eminnnnnnn/sensors_control_system/docs/kicad project/course.odt

Поз. обозначе- ние | Наименование | Кол. | Примечание
| Источники питания
BT1 | 3 В | 1
| Конденсаторы
C1 | 0,1 мкФ | 1
C2 | 10мк*10 | 1
C3-C9 | 0,1 мкФ | 7
C10, C11 | 15 пФ | 2
C12-C18 | 0,1 мкФ | 7
C19, C20 | 33 пФ | 2
| Схемы интегральные
D1 | BAT54C | 1
D2 | LED | 1
D3 | K1986BE92QI | 1
| Индикаторы символьные
HG1 | MT-12864j | 1
| Резисторы
R1-R5 | 10 кОм | 5
R6 | 1 кОм | 1
R7 | 10 кОм | 1
R8 | 3,3 кОм | 1
R9 | 47 кОм | 1
R10 | 10 кОм | 1
R11, R12 | 47 кОм | 2
R13, R14 | 10 кОм | 2
R15 | 47 кОм | 1

Подп. дата
Инв. № дубл.
Взам. инв. №
Подп. и дата
Инв. № подл.

| | | | | Система контроля показаний цифровых датчиков
Изм. | Лист | № докум. | Подп | Дата
Разраб. | | Гаджиев Э.А. | | | Перечень элементов | Лит. | | | Лист | Листов
Пров. | | Хохлов С.А. | | | | | | | 1 | 2
| | | | | | МГТУ им. Н.Э. Баумана
Н. контр.
Утв.

Поз. обозначе- ние | Наименование | Кол. | Примечание
| Выключатели кнопочные
SB1-SB6 | SB_PUSH_NO | 6
| Преобразователи
U1 | LM1117-3.3 | 1
| Схемы интегральные
U2 | DHT11 | 1
| Кварцевые резонаторы
Y1 | 8 МГц | 1
Y2 | Crystal | 1
| Фильтры
Z1 | BNX002 | 1

| | | | | Система контроля показаний цифровых датчиков | Лист
| | | | | | 2
Изм. | Лист | № докум. | Подп. | Дата

Подп. дата
Инв. № дубл.
Взам. инв. №
Подп. и дата
Инв. № подл.

Копировал Формат А4
