eminnnnnnn/sensors_control_system/docs/functional.JPG

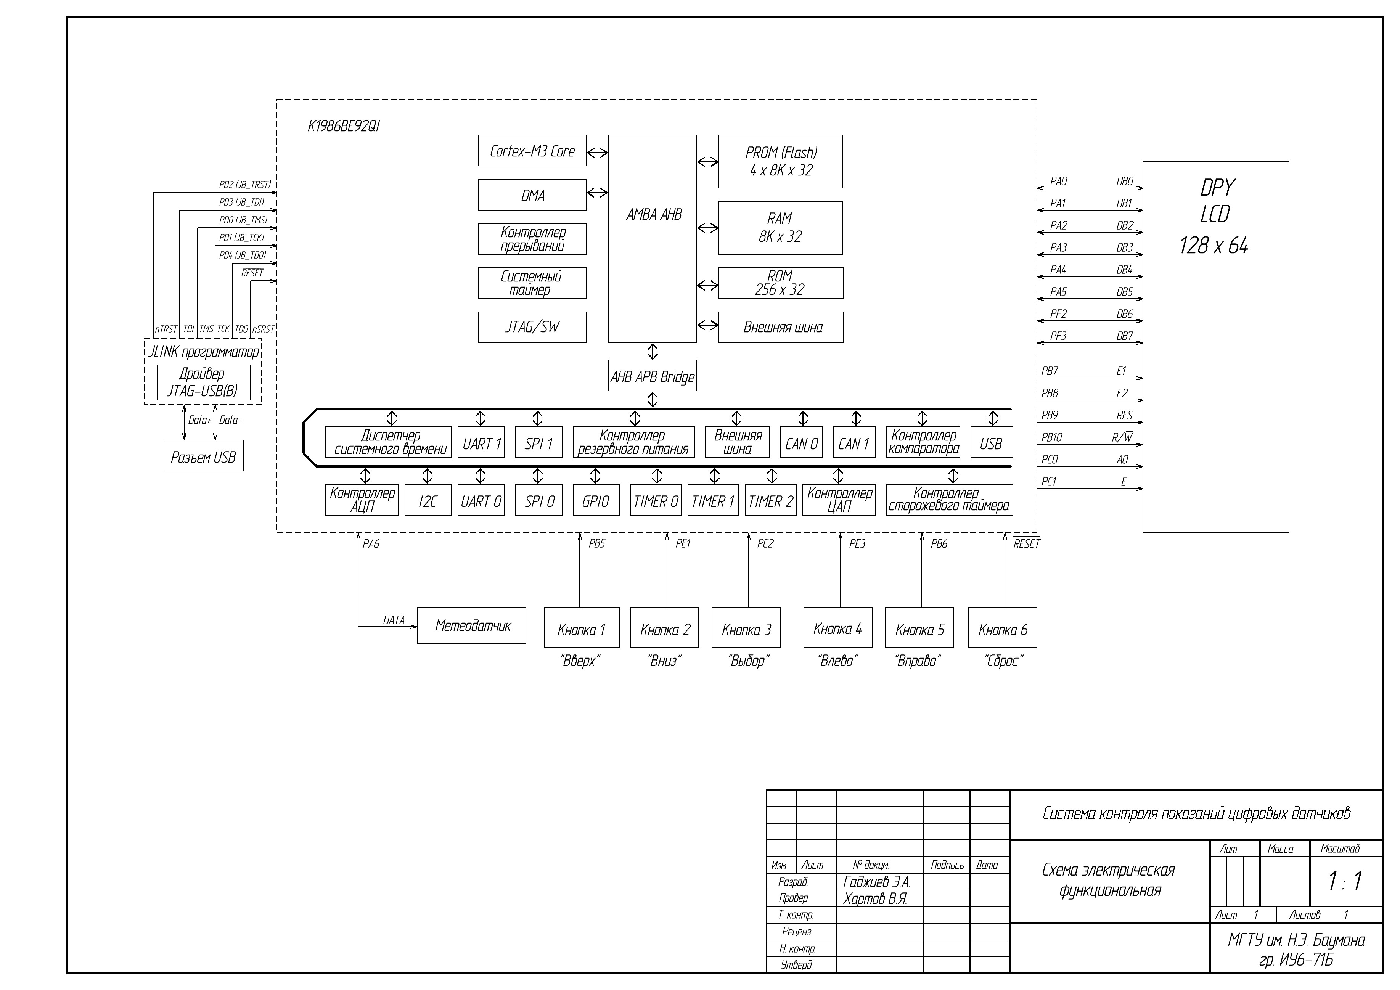
docs/functional.JPG
