eminnnnnnn/sensors_control_system/docs/principal.JPG

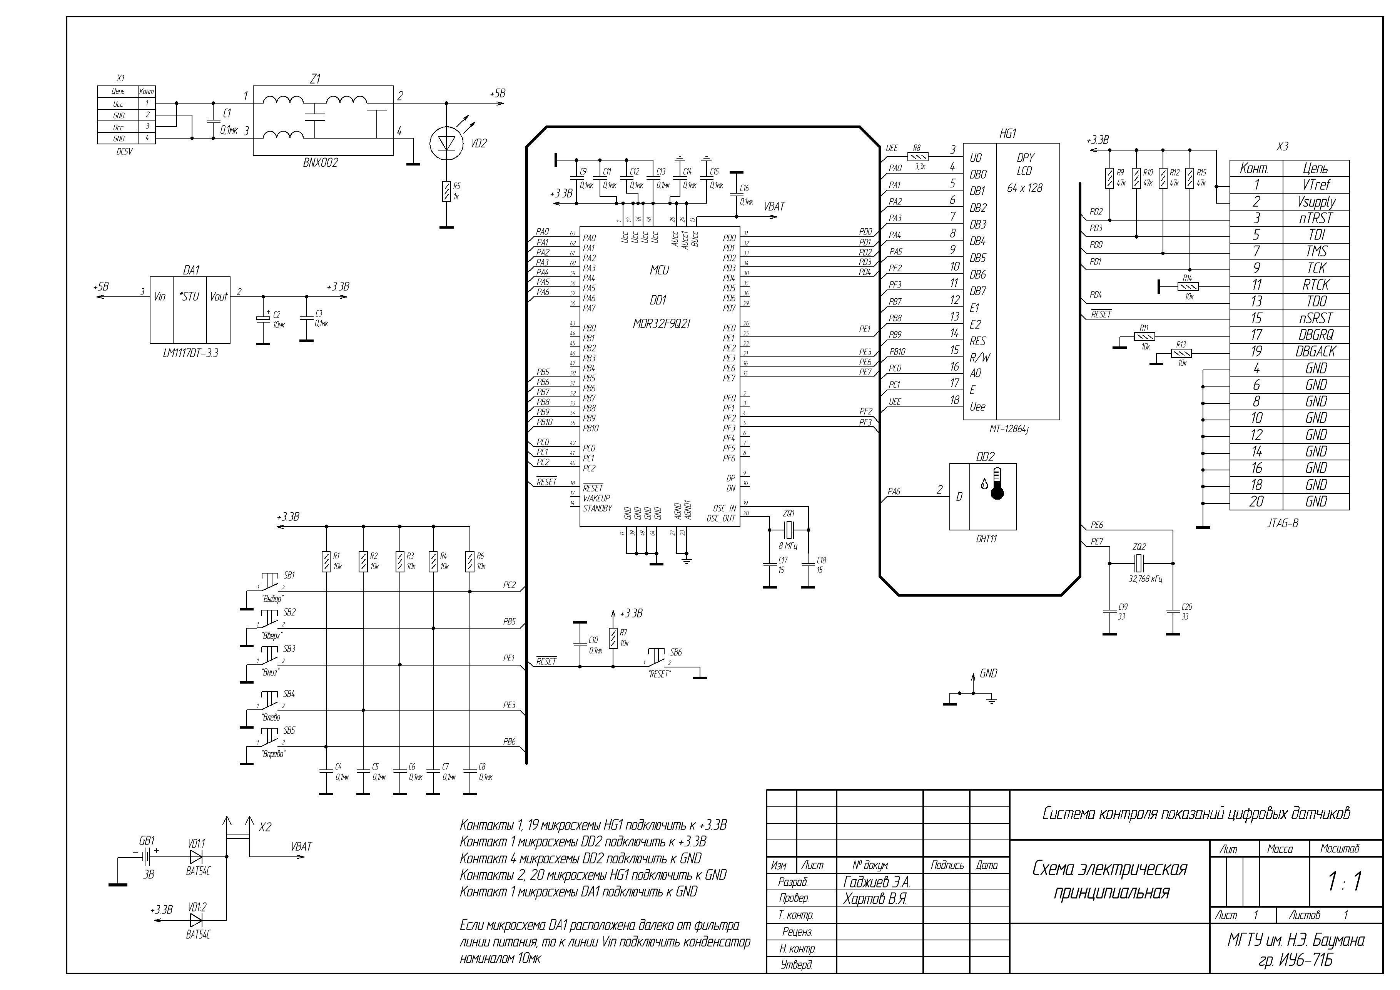
docs/principal.JPG
