eminnnnnnn/sensors_control_system/(list of files, drawings)

Other design files:
docs/functional.spl7
docs/principal.spl7
