eminnnnnnn/sensors_control_system/src/lcd_menu.c

#include "lcd_menu.h"
#include "auth.h"
#include "sensors.h"
#include "rtc.h"

//////////////////////////////////////////////////////////////////////////////////////////
/* ------------------------ PRIVATE FUNCTION DEFINITIONS ------------------------------ */
//////////////////////////////////////////////////////////////////////////////////////////

uint8_t * get_symbol_array_for_LCD(const char symbol)
{
	switch(symbol)
	{
		case 'a': return lat_a;
		case 'b': return lat_b;
		case 'c': return lat_c;
		case 'd': return lat_d;
		case 'e': return lat_e;
		case 'f': return lat_f;
		case 'g': return lat_g;
		case 'h': return lat_h;
		case 'i': return lat_i;
		case 'j': return lat_j;
		case 'k': return lat_k;
		case 'l': return lat_l;
		case 'm': return lat_m;
		case 'n': return lat_n;
		case 'o': return lat_o;
		case 'p': return lat_p;
		case 'q': return lat_q;
		case 'r': return lat_r;
		case 's': return lat_s;
		case 't': return lat_t;
		case 'u': return lat_u;
		case 'v': return lat_v;
		case 'w': return lat_w;
		case 'x': return lat_x;
		case 'y': return lat_y;
		case 'z': return lat_z;

		case 'A': return lat_A;
		case 'B': return lat_B;
		case 'C': return lat_C;
		case 'D': return lat_D;
		case 'E': return lat_E;
		case 'F': return lat_F;
		case 'G': return lat_G;
		case 'H': return lat_H;
		case 'I': return lat_I;
		case 'J': return lat_J;
		case 'K': return lat_K;
		case 'L': return lat_L;
		case 'M': return lat_M;
		case 'N': return lat_N;
		case 'O': return lat_O;
		case 'P': return lat_P;
		case 'Q': return lat_Q;
		case 'R': return lat_R;
		case 'S': return lat_S;
		case 'T': return lat_T;
		case 'U': return lat_U;
		case 'V': return lat_V;
		case 'W': return lat_W;
		case 'X': return lat_X;
		case 'Y': return lat_Y;
		case 'Z': return lat_Z;

		case '0': return dig_0;
		case '1': return dig_1;
		case '2': return dig_2;
		case '3': return dig_3;
		case '4': return dig_4;
		case '5': return dig_5;
		case '6': return dig_6;
		case '7': return dig_7;
		case '8': return dig_8;
		case '9': return dig_9;

		case '.': return sym_pt;
		// case '<': return sym_cursor;
		case '%': return sym_percent;
		case ' ': return sym_sp;
		case '>': return sym_arrow_right;
		case '<': return sym_arrow_left;
		case '^': return sym_arrow_up;
		case '/': return sym_arrow_down;
		case '!': return sym_exlam;

		default: return sym_sp;
	}
}

//////////////////////////////////////////////////////////////////////////////////////////
/* ----------------------- PUBLIC FUNCTION DEFINITIONS -------------------------------- */
//////////////////////////////////////////////////////////////////////////////////////////

int lcd_print_string(const char * str,
					 int y_pos,
					 lcd_output_effect_t is_smooth,
					 lcd_output_style_t is_inverted
					)
{
	if (!str || y_pos > (LCD_CHIP_PAGES - 1))
		return -1;

	const char * str_ptr = str;
	int x_pos = 0;

	// отображение на дисплей символов строки
	for (; (*(str_ptr) != 0x00) && (x_pos < LCD_MAX_STRING_SIZE); str_ptr++)
	{
		LcdPutChar(get_symbol_array_for_LCD(*str_ptr),
				   x_pos++,
				   y_pos,
				   is_smooth,
				   is_inverted
				  );
	}
	
	// рекурсивный вызов функции для переноса оставшихся символов на следующую строку
	if (*(str_ptr) != 0x00)
	{
		return lcd_print_string(str_ptr, y_pos + 1, is_smooth, is_inverted);
	}
	
	return y_pos;
}

void lcd_menu_init(void)
{
	// по умолчанию курсор на первом пункте меню, он отображается инвертированным
	lcd_print_string(MENU_ROWS_NAMES[0], 0, NOT_SMOOTH, INVERTED);
	for (int i = 1; i < MENU_ROWS_COUNT; ++i)
	{
		lcd_print_string(MENU_ROWS_NAMES[i], i, NOT_SMOOTH, NOT_INVERTED);
	}
}

void lcd_menu_handler(menu_rows_t * cursor, menu_action_t action)
{	
	// обработка нажатия кнопки "выбор"
	if (action == MENU_SELECT)
	{
		switch (*cursor)
		{
			case ROW_0: lcd_show_temperature();
			            return;
			case ROW_1: lcd_show_humidity();
				        return;
			case ROW_2: LcdFullClear();
						lcd_show_auth_arrows();
						input_new_password(); // ввод нового пароля
						lcd_hide_auth_arrows();
						lcd_menu_init(); // отображение меню
						*cursor = ROW_0; //  и перемещение курсора на первый пункт
						return;
			case ROW_3: LcdFullClear();
						run_login();	// процедура авторизации
						lcd_menu_init();
						*cursor = ROW_0;
						return;
			default: return;
		}
	}
	
	// обработка нажатий кнопок навигации в меню ("вверх", "вниз")

	menu_rows_t prev_row = *cursor; // сохранение текущей позиции курсора
	// сначала проверка граничных значений
	if ((*cursor == ROW_0) && (action == MENU_UP))
	{
		*cursor = MENU_ROWS_COUNT - 1; // перемещение курсора на последний пункт
	}
	else if ((*cursor == (MENU_ROWS_COUNT - 1)) && (action == MENU_DOWN))
	{
		*cursor = ROW_0; // перемещение курсора на первый пункт
	}
	else
	{
		// перемещение курсора в соответствии с действием
		*cursor = (menu_rows_t)((int)(*cursor) + (int)(action));
	}
	// выделение пункта, куда перемещен курсор
	lcd_print_string(MENU_ROWS_NAMES[(*cursor)], (*cursor), NOT_SMOOTH, INVERTED);
	// отмена выделения предыдущего пункта
	lcd_print_string(MENU_ROWS_NAMES[prev_row], prev_row, NOT_SMOOTH, NOT_INVERTED);
}

void lcd_show_auth_arrows(void)
{
	LcdPutChar(sym_arrow_up, UP_ARROW_X, UP_ARROW_Y, NOT_SMOOTH, NOT_INVERTED);
	LcdPutChar(sym_arrow_down, DOWN_ARROW_X, DOWN_ARROW_Y, NOT_SMOOTH, NOT_INVERTED);
	LcdPutChar(sym_arrow_right, RIGHT_ARROW_X, RIGHT_ARROW_Y, NOT_SMOOTH, NOT_INVERTED);
	LcdPutChar(sym_arrow_left, LEFT_ARROW_X, LEFT_ARROW_Y, NOT_SMOOTH, NOT_INVERTED);
}

void lcd_hide_auth_arrows(void)
{
	LcdPutChar(sym_sp, UP_ARROW_X, UP_ARROW_Y, NOT_SMOOTH, NOT_INVERTED);
	LcdPutChar(sym_sp, DOWN_ARROW_X, DOWN_ARROW_Y, NOT_SMOOTH, NOT_INVERTED);
	LcdPutChar(sym_sp, RIGHT_ARROW_X, RIGHT_ARROW_Y, NOT_SMOOTH, NOT_INVERTED);
	LcdPutChar(sym_sp, LEFT_ARROW_X, LEFT_ARROW_Y, NOT_SMOOTH, NOT_INVERTED);
}

void lcd_show_temperature(void)
{
	uint8_t sensor_data[DHT11_DATA_BYTES_SIZE - 1] = {0};
	LcdClearChip(2);	// очистка правой половина дисплея
	dht11_send_start();	// инициализация начала передачи данных
	if (dht11_read_data(sensor_data) == DHT11_SUCCESS)
	{
		lcd_show_time(get_sec());	// фиксация и вывод времени, когда получено значение
		if ((int8_t)sensor_data[DHT11_TEMP_INT_BYTE] < 0)
		{
			// если температура отрицательная
			LcdPutChar(sym_minus, 10, 2, NOT_SMOOTH, NOT_INVERTED);
		}
		// отображение значения температуры
		char tmp_symb = (sensor_data[DHT11_TEMP_INT_BYTE] / 10) + '0';
		LcdPutChar(get_symbol_array_for_LCD(tmp_symb), 11, 2, NOT_SMOOTH, NOT_INVERTED);
		tmp_symb = (sensor_data[DHT11_TEMP_INT_BYTE] % 10) + '0';
		LcdPutChar(get_symbol_array_for_LCD(tmp_symb), 12, 2, NOT_SMOOTH, NOT_INVERTED);
		/*
		LcdPutChar(sym_pt, 11, 3, NOT_SMOOTH, NOT_INVERTED);
		tmp_symb = sensor_data[DHT11_TEMP_DEC_BYTE] + '0';
		LcdPutChar(get_symbol_array_for_LCD(tmp_symb), 12, 2, NOT_SMOOTH, NOT_INVERTED);
		*/
		LcdPutChar(sym_degree_cels, 13, 2, NOT_SMOOTH, NOT_INVERTED);
	}
	else
	{
		lcd_show_sensor_error();
	}
}

void lcd_show_humidity(void)
{
	uint8_t sensor_data[DHT11_DATA_BYTES_SIZE - 1] = {0};
	LcdClearChip(2);
	dht11_send_start();
	if (dht11_read_data(sensor_data) == DHT11_SUCCESS)
	{
		// uint32_t measure_time = get_sec();
		lcd_show_time(get_sec()); // фиксация и вывод времени, когда получено значение
		// отображение значения влажности
		char tmp_symb = (sensor_data[DHT11_HUM_INT_BYTE] / 10) + '0';
		LcdPutChar(get_symbol_array_for_LCD(tmp_symb), 11, 2, NOT_SMOOTH, NOT_INVERTED);
		tmp_symb = (sensor_data[DHT11_HUM_INT_BYTE] % 10) + '0';
		LcdPutChar(get_symbol_array_for_LCD(tmp_symb), 12, 2, NOT_SMOOTH, NOT_INVERTED);
		/*
		tmp_symb = sensor_data[DHT11_HUM_DEC_BYTE] + '0';
		LcdPutChar(get_symbol_array_for_LCD(tmp_symb), 12, 2, NOT_SMOOTH, NOT_INVERTED);
		*/
		LcdPutChar(sym_percent, 13, 2, NOT_SMOOTH, NOT_INVERTED);
		// lcd_show_time(measure_time);
	}
	else
	{
		lcd_show_sensor_error();
	}
}

static void lcd_show_sensor_error(void)
{
	LcdPutChar(lat_e, 11, 3, NOT_SMOOTH, INVERTED);
	LcdPutChar(lat_r, 12, 3, NOT_SMOOTH, INVERTED);
	LcdPutChar(lat_r, 13, 3, NOT_SMOOTH, INVERTED);
}

static void lcd_show_time(uint32_t sec_time)
{
	uint32_t minutes = (sec_time / 60) % 60;
	uint32_t hours = sec_time / 3600;
	char tmp_symb = (char)(hours / 10) + '0';
	LcdPutChar(get_symbol_array_for_LCD(tmp_symb), 10, 4, NOT_SMOOTH, NOT_INVERTED);
	tmp_symb = (char)(hours % 10) + '0';
	LcdPutChar(get_symbol_array_for_LCD(tmp_symb), 11, 4, NOT_SMOOTH, NOT_INVERTED);

	LcdPutChar(sym_colon, 12, 4, NOT_SMOOTH, NOT_INVERTED);

	tmp_symb = (char)(minutes / 10) + '0';
	LcdPutChar(get_symbol_array_for_LCD(tmp_symb), 13, 4, NOT_SMOOTH, NOT_INVERTED);
	tmp_symb = (char)(minutes % 10) + '0';
	LcdPutChar(get_symbol_array_for_LCD(tmp_symb), 14, 4, NOT_SMOOTH, NOT_INVERTED);
}
