eminnnnnnn/sensors_control_system/(commit log)

2020-12-20 Interface for DHT11 sensor
2020-12-20 Sensor data display and fixed bug about re-measure failure (io port direction)
    [lcd_menu.c, lcd_menu.h, sensors.c, sensors.h]
2020-12-20 RTC module configs for display current time
2020-12-20 Some comments and 'minor big fixes'
    [auth.c, auth.h, eeprom_passw.c, eeprom_passw.h, init_configs.h, lcd_menu.c, lcd_menu.h, main.c]
2020-12-22 Added only 3 attempts to log in after which failure the system will be locked
    [auth.c, auth.h]
2020-12-22 Ports changed according to the debug board
2020-12-22 Minor bug fixes (attempts and lcd initial erase)
    [auth.c, mlt_lcd.c]
2020-12-30 'Failed re-measurement after timeout' bug fixes
    [sensors.c]
2020-12-30 Removed unnecessary connector for standy pin
    [principal.spl7]
